Bouhafs-Aek/bouhafs-Aek.github.io/hardware/bme688-breakout/bme688-breakout.kicad_pcb

## KiCad design hardware/bme688-breakout/bme688-breakout.kicad_pcb (2026-09-10)

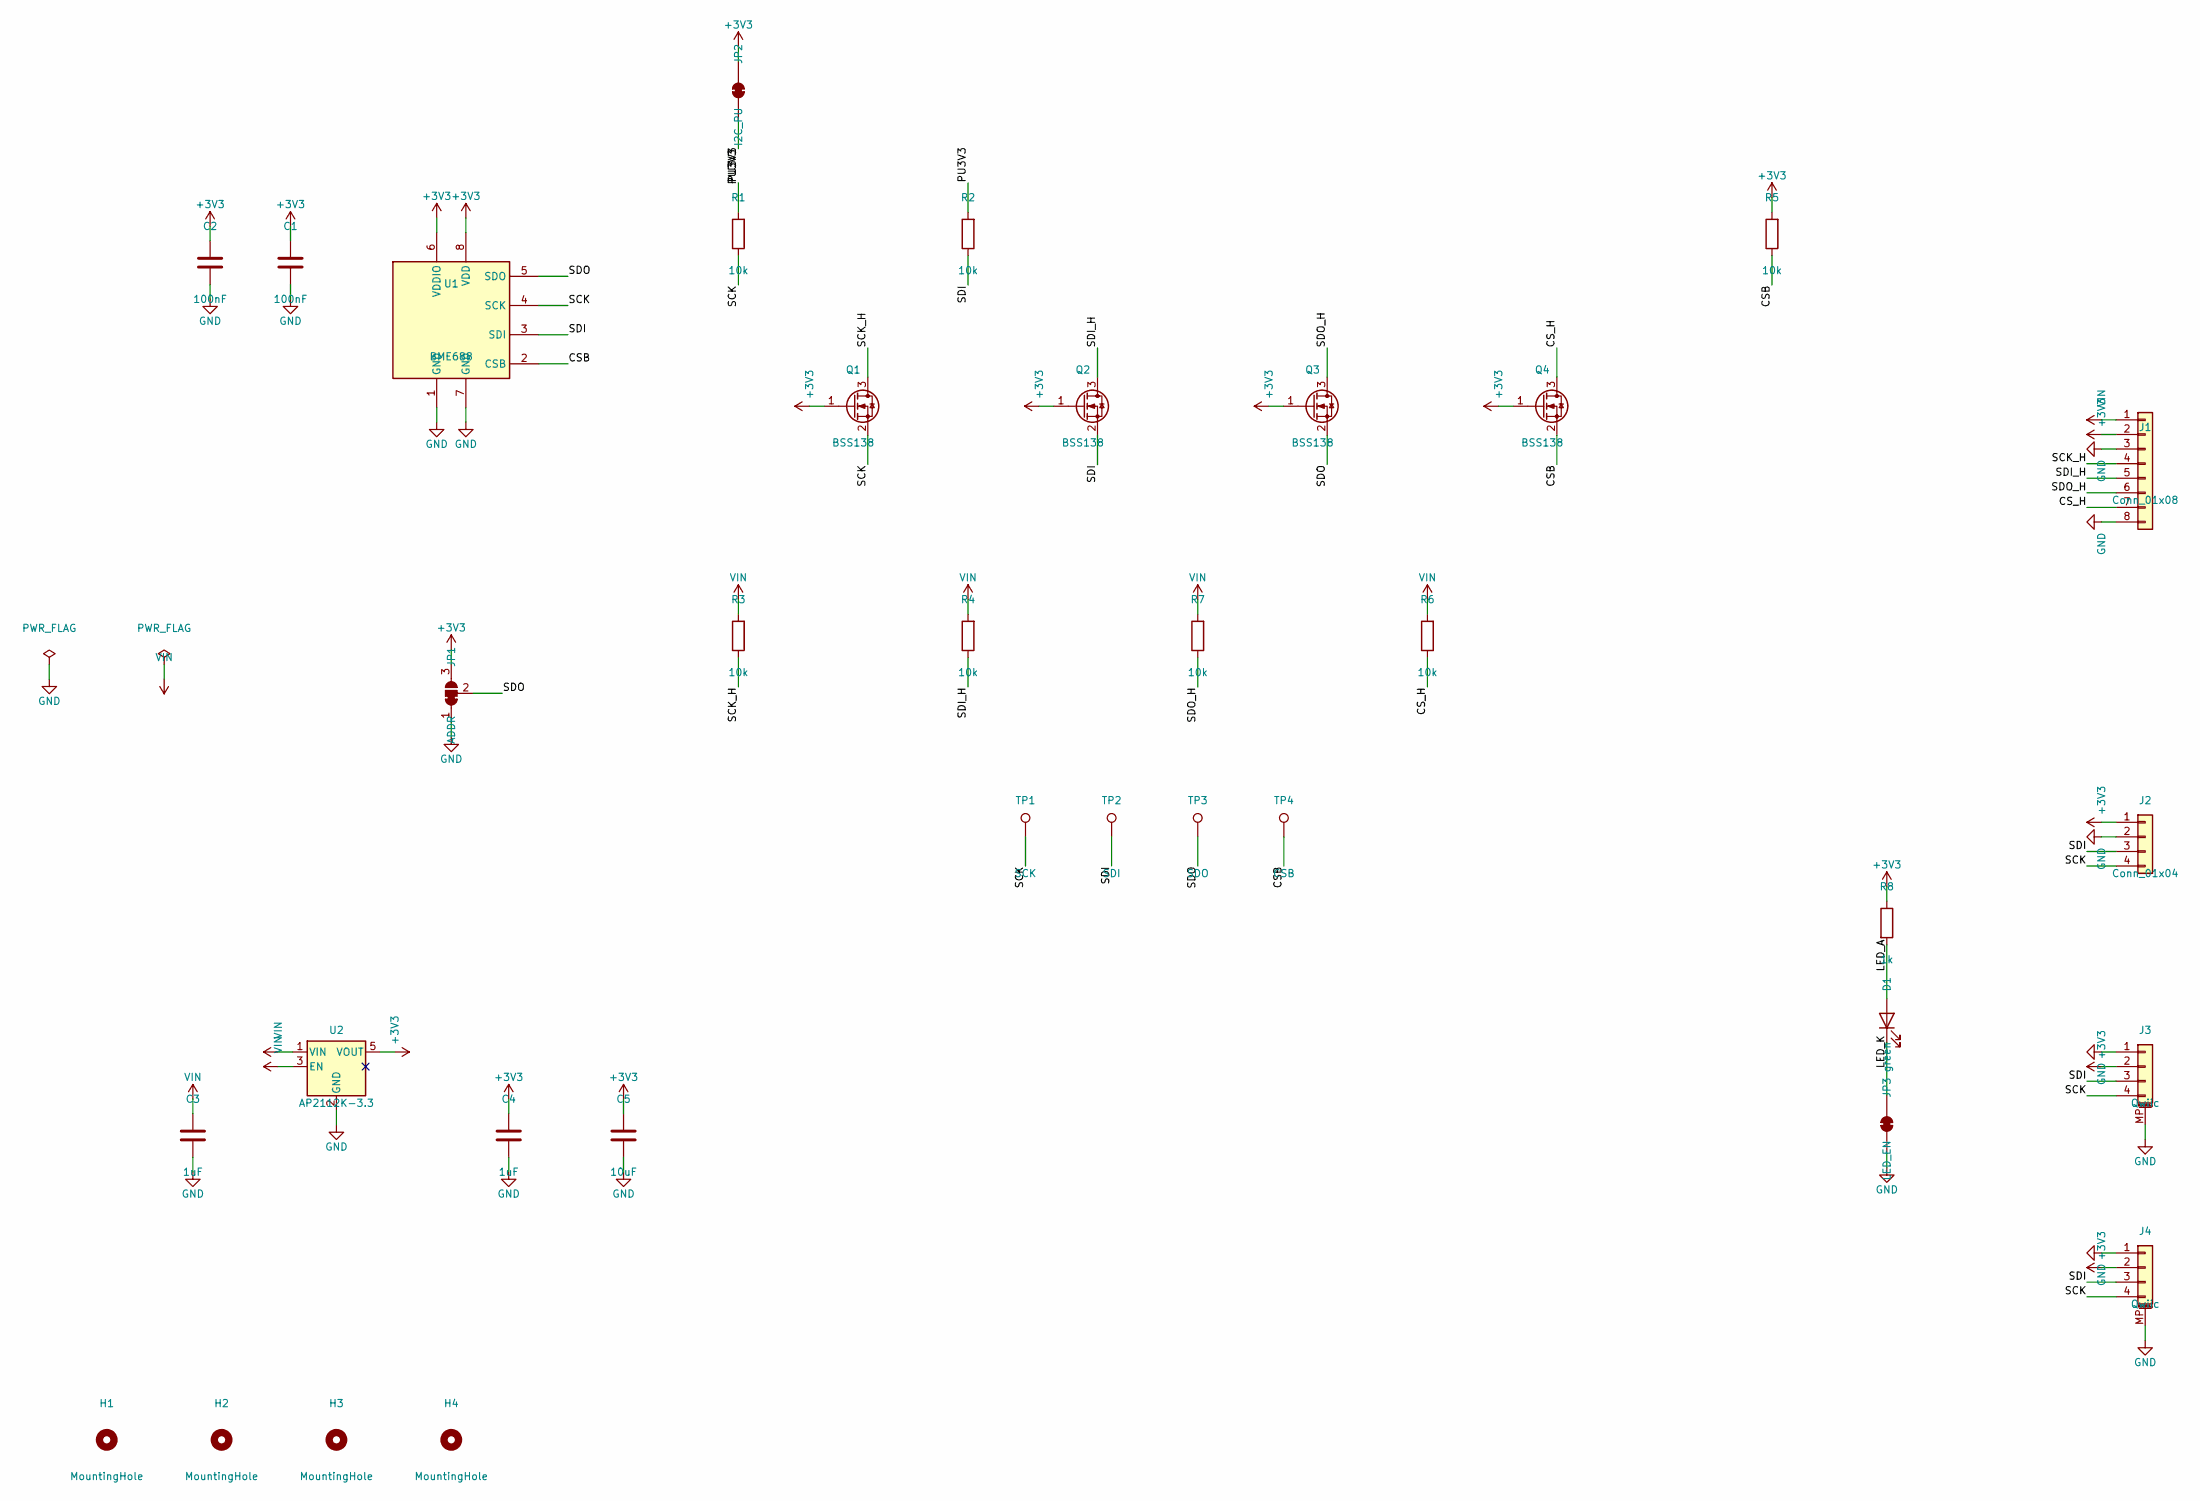
[picture p1: schematic bme688-breakout.kicad_sch, BME688 4-in-1 Environmental Sensor Breakout]

Parts:
C1, C2: 100nF; C_0603_1608Metric
C3, C4: 1uF; C_0603_1608Metric
C5: 10uF; C_0603_1608Metric
D1: green; LED_0603_1608Metric
H1, H2, H3, H4: MountingHole; MountingHole_2.2mm_M2
J1: Conn_01x08; PinHeader_1x08_P2.54mm_Vertical
J2: Conn_01x04; PinHeader_1x04_P2.54mm_Vertical
J3, J4: Qwiic; JST_SH_SM04B-SRSS-TB_1x04-1MP_P1.00mm_Horizontal
JP1: ADDR; SolderJumper-3_P1.3mm_Bridged12_RoundedPad1.0x1.5mm
JP2: I2C_PU; SolderJumper-2_P1.3mm_Bridged_RoundedPad1.0x1.5mm
JP3: LED_EN; SolderJumper-2_P1.3mm_Bridged_RoundedPad1.0x1.5mm
Q1, Q2, Q3, Q4: BSS138; SOT-23
R1, R2, R3, R4, R5, R6, R7: 10k; R_0603_1608Metric
R8: 1k; R_0603_1608Metric
TP1: SCK; TestPoint_Pad_D1.0mm
TP2: SDI; TestPoint_Pad_D1.0mm
TP3: SDO; TestPoint_Pad_D1.0mm
TP4: CSB; TestPoint_Pad_D1.0mm
U1: BME688; Bosch_LGA-8_3x3mm_P0.8mm_ClockwisePinNumbering
U2: AP2112K-3.3; SOT-23-5

Connections:
+3V3: C1.1, C2.1, C4.1, C5.1, J1.2, J2.1, J3.2, J4.2, JP1.3, JP2.1, Q1.1, Q2.1, Q3.1, Q4.1, R5.2, R8.1, U1.6, U1.8, U2.5
CSB: Q4.2, R5.1, TP4.1, U1.2
CS_H: J1.7, Q4.3, R6.1
GND: C1.2, C2.2, C3.2, C4.2, C5.2, J1.3, J1.8, J2.2, J3.1, J3.MP, J4.1, J4.MP, JP1.1, JP3.2, U1.1, U1.7, U2.2
LED_A: D1.2, R8.2
LED_K: D1.1, JP3.1
PU3V3: JP2.2, R1.2, R2.2
SCK: J2.4, J3.4, J4.4, Q1.2, R1.1, TP1.1, U1.4
SCK_H: J1.4, Q1.3, R3.1
SDI: J2.3, J3.3, J4.3, Q2.2, R2.1, TP2.1, U1.3
SDI_H: J1.5, Q2.3, R4.1
SDO: JP1.2, Q3.2, TP3.1, U1.5
SDO_H: J1.6, Q3.3, R7.1
VIN: C3.1, J1.1, R3.2, R4.2, R6.2, R7.2, U2.1, U2.3

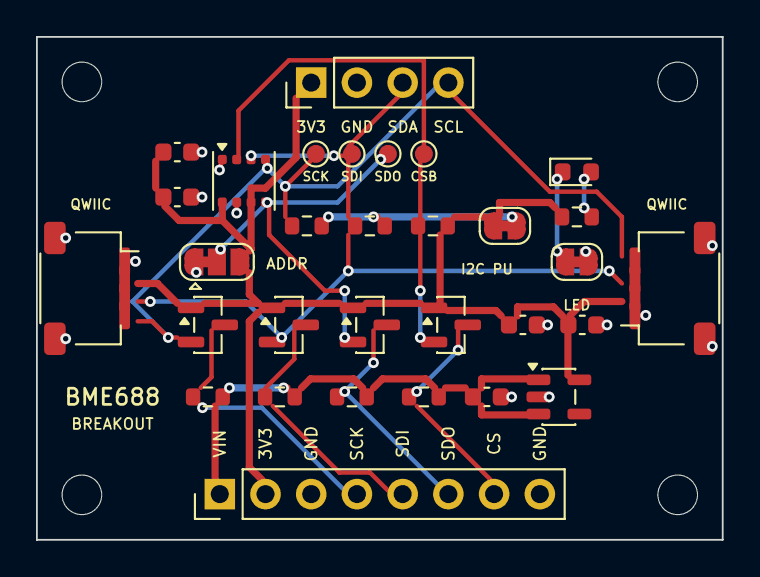
[picture p2: board bme688-breakout.kicad_pcb from above]

Board: 2 copper layers, 38.1 x 27.9 mm, 35 parts (0 on the bottom side), 14 nets.
