Bouhafs-Aek/bouhafs-Aek.github.io/(commit log)

2026-09-10 Add BME688 environmental sensor breakout: KiCad schematic and PCB
    Host-agnostic breakout for the Bosch BME688 (gas/VOC, humidity, pressure,
    temperature). Works with any I2C or SPI MCU at 1.8-5.5V logic via a
    level-shifted 0.1" header, plus two Qwiic/STEMMA QT connectors for
    daisy-chaining on the 3.3V side.
    The request named a "BLE688", which is not a real part in any manufacturer
    or distributor catalogue; the intended part was confirmed as the BME688.
    KiCad 9 has no BME688 symbol, so lib/ restates the pin- and
    package-compatible BME680 symbol with BME688 identity, over KiCad's own
    reviewed Bosch LGA-8 land pattern.
    Design:
    - AP2112K-3.3 LDO (2.5-6V in), 4x BSS138 bidirectional level shifte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
    [bme688-breakout.kicad_pcb, bme688-breakout.kicad_sch, bom.csv]
2026-09-10 Retarget the BME688 breakout to the KiCad 10 file formats
    Schematic, board, symbol library and project file are now written in the
    KiCad 10 formats instead of KiCad 9:
    kicad_sch 20250114 -> 20250901
    kicad_pcb 20241229 -> 20250907
    kicad_sym 20241209 -> 20251024
    Token forms were taken from the demo project and libraries shipped with the
    KiCad 10.0.6 release, and the symbol/footprint caches refetched from the
    10.0.6 library tags (KiCad 10 stores symbols as <Lib>.kicad_symdir with one
    file per symbol; the ones used here are merged back per library).
    Format changes applied:
    - symbol properties carry (hide yes) on the property itself rather than
    inside (effects ...), in both instance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
    [bme688-breakout.kicad_pcb, bme688-breakout.kicad_sch]
